ersil/framedrop/firmware/partitions_printdrop_ota.csv

# PrintDrop OTA partition table for a 4 MB ESP32-S3.
#
# Dual OTA slots + LittleFS. Each app slot is 0x150000 (1 344 KB) — enough for
# the current ~930 KB firmware with headroom. OTA data at 0xE000. LittleFS
# stays at 0x2B0000 so existing `uploadfs` offsets remain valid.
#
# Name | Type | SubType | Offset | Size | Flags
nvs | data | nvs | 0x9000 | 0x5000
otadata | data | ota | 0xE000 | 0x2000
app0 | app | ota_0 | 0x10000 | 0x150000
app1 | app | ota_1 | 0x160000 | 0x150000
spiffs | data | spiffs | 0x2B0000 | 0x140000
coredump | data | coredump | 0x3F0000 | 0x10000
