ersil/framedrop/firmware/src/printdrop/config.h

#pragma once

// PrintDrop — build-wide configuration.

#ifndef PRINTDROP_VERSION
#define PRINTDROP_VERSION "0.0.0-dev"
#endif

#ifndef PRINTDROP_NAME
#define PRINTDROP_NAME "PrintDrop"
#endif

// ---------------------------------------------------------------------------
// SD bus selection
// ---------------------------------------------------------------------------
// feat/sdio: SDIO 4-bit via the ESP32-S3 SDMMC host is the default (USE_SDIO).
// Undefine it to build the legacy 4-wire SPI driver (env printdrop_spi).
// The two drivers share the same high-level contract (one mutex, withdraw
// before writing, remount when the host writes) so the rest of the firmware
// is bus-agnostic.

// SD card wiring — SPI (legacy, 4 wires, overridden from platformio.ini).
#ifndef SD_CS_PIN
#define SD_CS_PIN   12
#endif
#ifndef SD_MISO_PIN
#define SD_MISO_PIN 39
#endif
#ifndef SD_MOSI_PIN
#define SD_MOSI_PIN 14
#endif
#ifndef SD_CLK_PIN
#define SD_CLK_PIN  40
#endif

// Verified clean to 25 MHz on this wiring; 20 MHz leaves margin.
#ifndef SD_SPI_FREQ
#define SD_SPI_FREQ 20000000
#endif

// SD card wiring — SDIO 4-bit (feat/sdio, 6 wires, overridden from
// platformio.ini). Reuses the four SPI pins plus two new data lines so an
// SPI-wired board migrates with two extra jumpers. SDIO requires a 3.3 V-native
// microSD breakout (no AMS1117/LC125) with 10 k pull-ups on CMD and D0-D3.
#ifndef SDMMC_CLK_PIN
#define SDMMC_CLK_PIN 40
#endif
#ifndef SDMMC_CMD_PIN
#define SDMMC_CMD_PIN 14
#endif
#ifndef SDMMC_D0_PIN
#define SDMMC_D0_PIN  39
#endif
#ifndef SDMMC_D1_PIN
#define SDMMC_D1_PIN  12
#endif
#ifndef SDMMC_D2_PIN
#define SDMMC_D2_PIN  13
#endif
#ifndef SDMMC_D3_PIN
#define SDMMC_D3_PIN  15
#endif

// SDMMC bus width: 1 or 4. 4-bit is ~3-4x faster; 1-bit is useful for
// bring-up when only CLK/CMD/D0 are wired.
#ifndef SDMMC_WIDTH
#define SDMMC_WIDTH 4
#endif

// SDMMC frequency in Hz. 40 MHz is the SDHC high-speed limit; 20 MHz is
// conservative on jumper wiring and still ~4x faster than SPI at 20 MHz.
#ifndef SDMMC_FREQ
#define SDMMC_FREQ 40000000
#endif

// Not every plausible frequency is survivable. The SDMMC host rounds a request
// it cannot divide to exactly, and when the result exceeds what the card
// advertises the IDF aborts inside sdmmc_init_host_frequency:
//
//   assert failed: sdmmc_init_host_frequency sdmmc_common.c:198
//   (card->max_freq_khz <= card->host.max_freq_khz)
//
// That is a boot loop, and since SDMMC_FREQ is a build flag the board cannot be
// talked out of it -- it has to be reflashed. 25 MHz does this, and so does
// 32 MHz, despite 25 MHz being this card's own advertised tr_speed. So the list
// below is the set measured to actually work on hardware rather than the set
// that looks reasonable. Add to it from upstream PrintDrop's bench_sdio measurements, or set
// SDMMC_FREQ_UNCHECKED to take responsibility for a value yourself.
#if defined(USE_SDIO) && !defined(SDMMC_FREQ_UNCHECKED)
#if SDMMC_FREQ != 40000000 && SDMMC_FREQ != 20000000 && \
    SDMMC_FREQ != 10000000 && SDMMC_FREQ !=  4000000 && \
    SDMMC_FREQ !=  1000000
#error "SDMMC_FREQ is not one of the frequencies measured to work (40, 20, 10, 4 or 1 MHz). Others can abort at boot and leave a board that only a reflash recovers; see upstream PrintDrop's docs/bugs.md. Define SDMMC_FREQ_UNCHECKED to override."
#endif
#endif

// Fallback access point used when no credentials are stored, or the stored
// network cannot be joined.
#ifndef AP_SSID_PREFIX
#define AP_SSID_PREFIX  "PrintDrop-Setup"
#endif
// The setup network's password has no default; tools/build_secrets.py sets it
// from PHOTOFRAME_SETUP_PASSWORD. WPA2 needs at least 8 characters.
#ifndef AP_PASSWORD
#error "AP_PASSWORD is not set; build with tools/build_secrets.py"
#endif
#ifndef DEFAULT_HOSTNAME
#define DEFAULT_HOSTNAME "printdrop"
#endif

// How long to wait for the configured network before falling back to the AP.
#define WIFI_CONNECT_TIMEOUT_MS 20000

// ---------------------------------------------------------------------------
// Status LED and factory-reset button (feat/ux)
// ---------------------------------------------------------------------------
// LED: heartbeat when idle (2 s period), rapid blink on SD/USB activity.
// Set to -1 to disable. Wiring: LED + resistor to GND (active-high) or 3V3
// (active-low) — define accordingly.
#ifndef PRINTDROP_LED_PIN
#define PRINTDROP_LED_PIN 38
#endif
#ifndef PRINTDROP_LED_ACTIVE_HIGH
#define PRINTDROP_LED_ACTIVE_HIGH 1
#endif

// Button: short press = eject/refresh printer view, long press 5-10 s = factory
// reset (clears Wi-Fi + auth). Active-low with internal pull-up by default.
#ifndef PRINTDROP_BUTTON_PIN
#define PRINTDROP_BUTTON_PIN 4
#endif
#ifndef PRINTDROP_BUTTON_ACTIVE_LOW
#define PRINTDROP_BUTTON_ACTIVE_LOW 1
#endif
#define BUTTON_FACTORY_RESET_MS 5000
#define BUTTON_EJECT_MS 50

// ---------------------------------------------------------------------------
// Telling the USB host its cached filesystem is stale
// ---------------------------------------------------------------------------
// How long the medium stays withdrawn after UNIT ATTENTION is raised, so a host
// polling once or twice a second collects it before the card returns.
#ifndef USB_MEDIA_CHANGED_MS
#define USB_MEDIA_CHANGED_MS 800
#endif
// How long to stay off the bus during a forced re-enumeration. Long enough for
// the host to tear the device down; short enough not to look like a failure.
#ifndef USB_DETACH_MS
#define USB_DETACH_MS 600
#endif
// Whether refreshHostView() re-enumerates rather than relying on the medium
// cycle. Set from measurement, not taste: see upstream PrintDrop's docs/bugs.md.
#ifndef USB_FORCE_REATTACH
#define USB_FORCE_REATTACH 0
#endif

// Batching, in both modes. With USB_FORCE_REATTACH a batch keeps the device off
// the USB bus and reconnects once at the end. Without it the medium stays
// presented through the batch and is pulsed once at the end (withdrawn, UNIT
// ATTENTION, presented again). Any number of files can go in one batch.
//
// Explicit batch: POST /api/batch/begin, upload the files, POST
// /api/batch/end. The device stays off the bus until end, however long the
// gaps between files. If end never arrives (the client went away), it
// reconnects after USB_BATCH_ABANDON_MS without a write.
//
// Implicit batch: a write with no batch open starts one, and the device
// reconnects after USB_BATCH_QUIET_MS without a write. The timer starts when a
// write finishes; an upload in progress holds the write lock, so a slow upload
// never triggers it. 30 s covers a client pausing between files, for example
// a phone converting the next photo.
// How long the setup network stays up with nobody on it before the device
// restarts to try the saved home Wi-Fi again. Each restart replugs the drive,
// so a router that is down for an hour costs six of them, not twenty.
#ifndef WIFI_AP_RETRY_MS
#define WIFI_AP_RETRY_MS 600000
#endif
// How long the device may be off the home Wi-Fi before it restarts to rejoin.
// It asks the driver to reconnect every minute before that.
#ifndef WIFI_LOST_RESTART_MS
#define WIFI_LOST_RESTART_MS 600000
#endif

#ifndef USB_BATCH_QUIET_MS
#define USB_BATCH_QUIET_MS 30000
#endif
#ifndef USB_BATCH_ABANDON_MS
#define USB_BATCH_ABANDON_MS 600000
#endif

// Offer the card to the USB host as write-protected. This is the switch that
// makes sharing safe rather than merely careful: a host that cannot write can
// neither cache dirty FAT metadata nor flush it back over an upload, which is
// the corruption measured in upstream PrintDrop's docs/bugs.md. The cost is that files can no longer
// be dragged onto the card over USB -- the web UI becomes the only writer,
// which for a print-drop box is the intended flow anyway.
//
// Set to 0 for a read-write host, and read the warning in README first.
#ifndef USB_READ_ONLY
#define USB_READ_ONLY 1
#endif

// How many consecutive failed transfers mean the card has stopped answering
// rather than hiccuped, and how often to retry a mount once it has.
#ifndef SD_FAULT_THRESHOLD
#define SD_FAULT_THRESHOLD 8
#endif
#ifndef SD_REMOUNT_INTERVAL_MS
#define SD_REMOUNT_INTERVAL_MS 5000
#endif
// Retries back off to this, so a board with no card does not spend loopTask on
// the SDMMC host and leave the web UI crawling.
#ifndef SD_REMOUNT_MAX_MS
#define SD_REMOUNT_MAX_MS 60000
#endif

// How often an upload broadcasts progress over the websocket. One frame per
// 1436-byte chunk is ~140 frames per megabyte, sent from the same task that is
// doing the upload.
#ifndef UPLOAD_PROGRESS_INTERVAL_MS
#define UPLOAD_PROGRESS_INTERVAL_MS 250
#endif

// ---------------------------------------------------------------------------
// Web UI authentication (feat/ux)
// ---------------------------------------------------------------------------
// User and SHA-256 hex of password (64 chars). Stored in NVS namespace
// "printdrop" keys "auth_user"/"auth_hash"; build_flags supply the initial
// seed so a fresh flash is not open. Example: echo -n "newPass" | sha256sum
#ifndef PRINTDROP_AUTH_USER
#define PRINTDROP_AUTH_USER "admin"
#endif
// No default: a board built without a password would ship with a publicly
// known one. tools/build_secrets.py sets it from PHOTOFRAME_WEB_PASSWORD.
#ifndef PRINTDROP_AUTH_PASS_HASH
#error "PRINTDROP_AUTH_PASS_HASH is not set; build with tools/build_secrets.py"
#endif
// Set to 0 to ship open (not recommended on shared LAN).
#ifndef PRINTDROP_AUTH_REQUIRED
#define PRINTDROP_AUTH_REQUIRED 1
#endif

// ---------------------------------------------------------------------------
// Discovery (feat/ux)
// ---------------------------------------------------------------------------
// mDNS is always on. LLMNR answers single-label names (e.g. http://printdrop)
// on Windows without Bonjour. Both advertise the same hostname.
#ifndef PRINTDROP_ENABLE_LLMNR
#define PRINTDROP_ENABLE_LLMNR 1
#endif
#ifndef PRINTDROP_ENABLE_MDNS
#define PRINTDROP_ENABLE_MDNS 1
#endif

// ---------------------------------------------------------------------------
// OTA (feat/ux)
// ---------------------------------------------------------------------------
// OTA via HTTP POST /api/ota and via SD card file `firmware.bin` + `firmware.json`.
// Requires partitions_printdrop_ota.csv (dual app slots). Define 0 to remove OTA
// code on very tight builds.
#ifndef PRINTDROP_ENABLE_OTA
#define PRINTDROP_ENABLE_OTA 1
#endif
#define OTA_SD_FIRMWARE_PATH "/firmware.bin"
#define OTA_SD_META_PATH     "/firmware.json"
