ersil/framedrop/(commit log)

2026-10-15 Initial release of FrameDrop
    FrameDrop lets a digital photo frame that only reads USB drives receive
    photos over Wi-Fi. An ESP32-S3 SuperMini, plugged into the frame's USB port,
    presents a microSD card as a read-only USB drive, serves an upload page and
    API on the home network, and tells the frame when new photos arrive, without
    stopping its slideshow.
    The firmware is a fork of PrintDrop (MIT). It includes patched copies of the
    Arduino-ESP32 SD library (Apache-2.0) and WebServer library (LGPL-2.1). An iOS
    Shortcut sends photos from the iPhone share sheet.
    [partitions.csv, partitions_printdrop.csv, partitions_printdrop_ota.csv]
2026-10-15 Fix the library and docs READMEs shown on GitHub
    firmware/lib/SD/README.md was Espressif's upstream README, which GitHub
    renders with broken bold text and an old alert style, and which documents
    direct card wiring and other chips' default pins. Each patched library's
    README now describes this project's changes (formerly PHOTOFRAME.md) and
    links to the upstream library.
    firmware/docs/README.md was upstream PrintDrop's index, with links to files
    this repo does not have. It now lists the pages that exist and says they
    describe upstream's hardware.
2026-10-15 Remove upstream PrintDrop material that FrameDrop does not use
    - firmware/docs: upstream's documentation for its DevKitC board with SDIO.
    The README links to upstream's copy instead.
    - The diag, scan, msc, ramdisk and SDIO build environments, their sources,
    and the single-app partition table only they used. photoframe and
    photoframe_sd_diag remain, and both build.
    - poc/: the first proof of concept, which served a test image from flash.
    The README now describes the frame in general terms and names the NIX as
    the frame it was tested with, and drops build internals a user does not
    need.
    [partitions.csv, partitions_printdrop.csv]
2026-10-15 Add an optional Mac setup step to the build instructions
    The README gets a "Setting up a Mac" section: Command Line Tools for clang
    and git, PlatformIO and direnv from Homebrew, the board's port name, and why
    uploadfs fails on Apple Silicon. The build commands now include flashing the
    web UI image.
    build_ui_image.sh printed an esptool 5 command (write-flash). PlatformIO's
    bundled esptool is 4.11, which accepts only write_flash, so the script now
    prints a command that runs PlatformIO's esptool.
2026-10-15 Rewrite the README in the order a new user needs it
    The README mixed setup, reference and internals: first setup came after
    the update and USB flashing sections, developer details sat between user
    steps, and it never said how to add photos. It is now: what you need,
    wiring, six numbered install steps, adding photos, updating,
    troubleshooting, security, how it works, and the license.
    Each build command was run from a fresh clone with an empty PlatformIO
    home. The steps that write to a board were not run.
2026-10-15 Drop direnv from the README and tighten the install steps
    The build only needs the variables in the environment, so step 2 shows
    plain export lines. The Mac step is brew install platformio, since
    Homebrew's installer already sets up clang and git. Also removes the SPI
    clock note, gives the settings table a header, and rewords the note on
    flashing over USB after the first install.
2026-10-15 Review the README five times and fix what each pass found
    Accuracy: photos are always saved as JPEG but shrunk only when larger than
    1920 px; the crash report shows the first 16 characters of the ELF's
    SHA-256 (checked against a build), and the README says how to match it; a
    5 s BOOT press clears all Wi-Fi settings, not only the network.
    New user: add the clone step and the Unix shell requirement, warn that the
    first build downloads the toolchain, say to leave the serial monitor before
    flashing, name the Scan networks button, and note that updates must use
    the same settings.
    Also: shorter step 4 explanation, sha256sum for Linux, rewrapped lines,
    and plainer wording for the Origin check. NI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
    [web.cpp]
2026-10-15 Name PrintDrop once in the README
2026-10-23 Give the web UI password prompt its own login form
    The password prompt reused the generic text input and switched it to type password when opened. Desktop password managers classified that lone text input as a username field and filled the saved username into it, so the first login attempt sent the username as the password and failed with a 401. A refresh changed the classification, which is why the second attempt worked.
    The prompt now has its own form with a visually hidden username field set to the current user and a password input that is type password with autocomplete current-password from the start. OK and Enter submit the form, which lets the browser offer to save the credential. Th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
2026-10-25 Fix upload hangs, OOM crash paths and SD write error handling
    Found by bounded model checking (CBMC) of the upload parser, the request
    intake and the SD driver.
    WebServer (Parsing.cpp):
    - Multipart lines are read by _readFormLine, which gives up after
    HTTP_MAX_POST_WAIT with no byte, a line over 8 KB, or a failed String
    allocation. A truncated upload used to spin loopTask until a power cycle.
    - Form field values are capped at 8 KB in total, and the argument table is
    freed when a request fails.
    - The request line is checked for failed allocations before atoi.
    - A negative Content-Length and header lines over 2 KB are refused.
    SD driver (sd_diskio.cpp):
    - Only data response 0x05 counts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
    [web.cpp]
